dezash123/watch/README.md

Circuit board for my custom smartwatch!!!!!

[OS](https://github.com/dezash123/watch-os)

[MCAD](https://cad.onshape.com/documents/7a2f9e69e051d257ea5e1b33/)
