dezash123/watch/pcb/custom-lib/models/AFE4420YZT.step

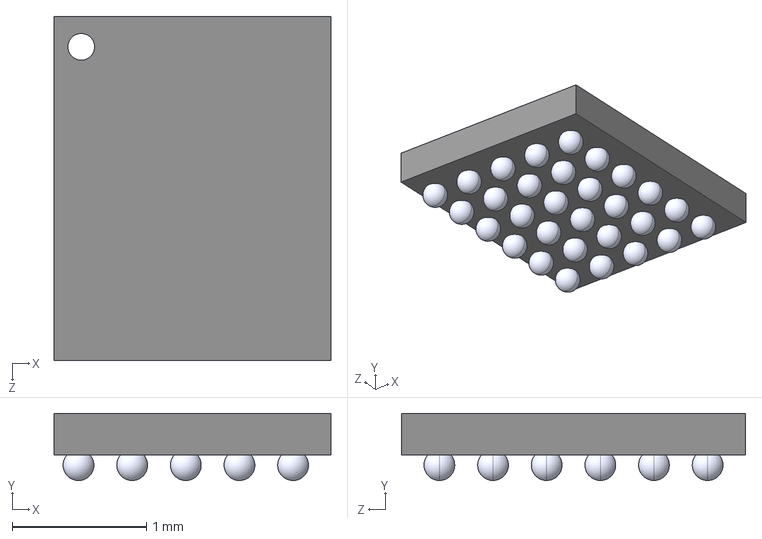
[picture p1: CAD file, 2024-07-04]
pcb/custom-lib/models/AFE4420YZT.step
2.07 x 0.5 x 2.57 mm
