dezash123/watch/pcb/custom-lib/models/MX25LM51245GXDI00.step

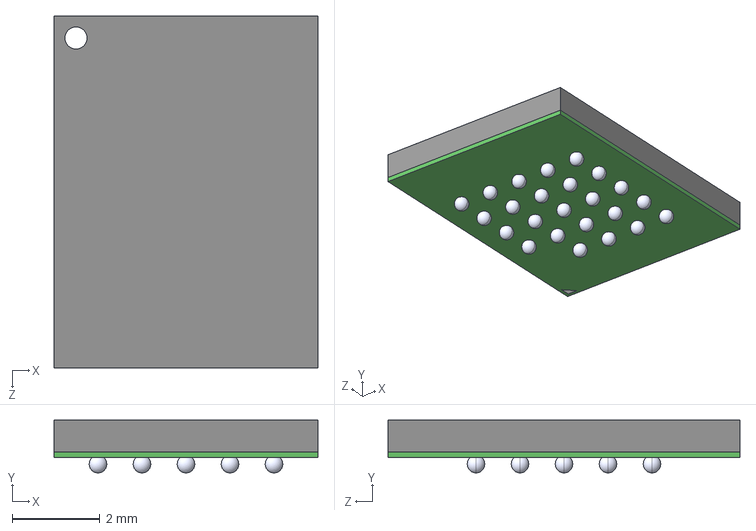
[picture p2: CAD file, 2024-07-04]
pcb/custom-lib/models/MX25LM51245GXDI00.step
6.00 x 1.20 x 8.00 mm
Body^MX25LM51245GXDI00
ball^MX25LM51245GXDI00 x 24
