dezash123/watch/pcb/custom-lib/models/MAX30102EFD_T.step

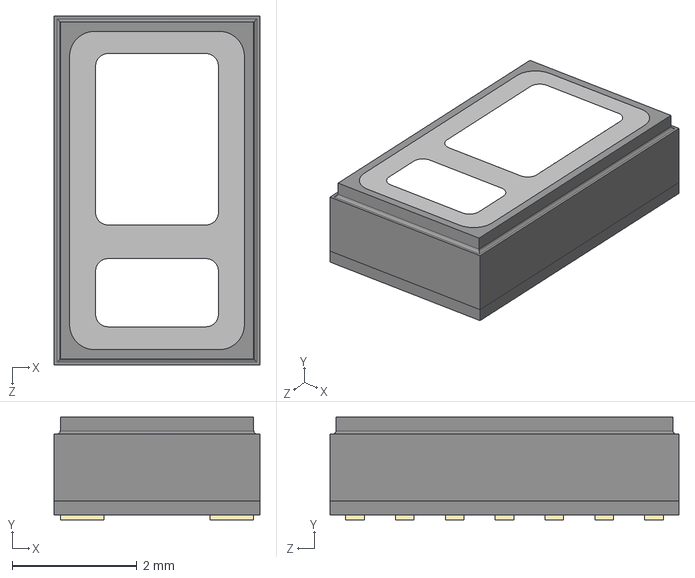
[picture p3: CAD file, 2024-07-04]
pcb/custom-lib/models/MAX30102EFD_T.step
3.30 x 1.65 x 5.60 mm
