dezash123/watch/pcb/custom-lib/models/TPS63021DSJR.step

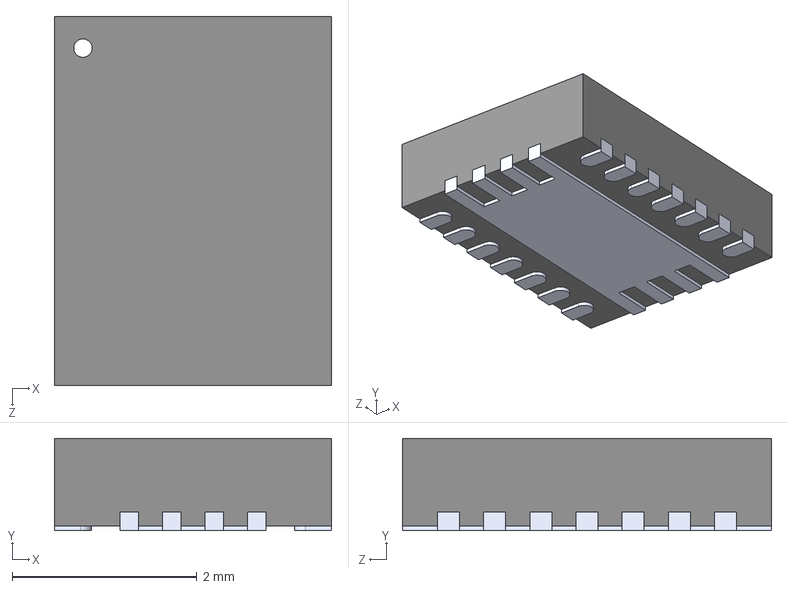
[picture p4: CAD file, 2024-07-04]
pcb/custom-lib/models/TPS63021DSJR.step
3.00 x 1.00 x 4.00 mm
