dezash123/watch/pcb/watch-pcb.kicad_pcb

## KiCad design pcb/watch-pcb.kicad_pcb (2024-07-31)

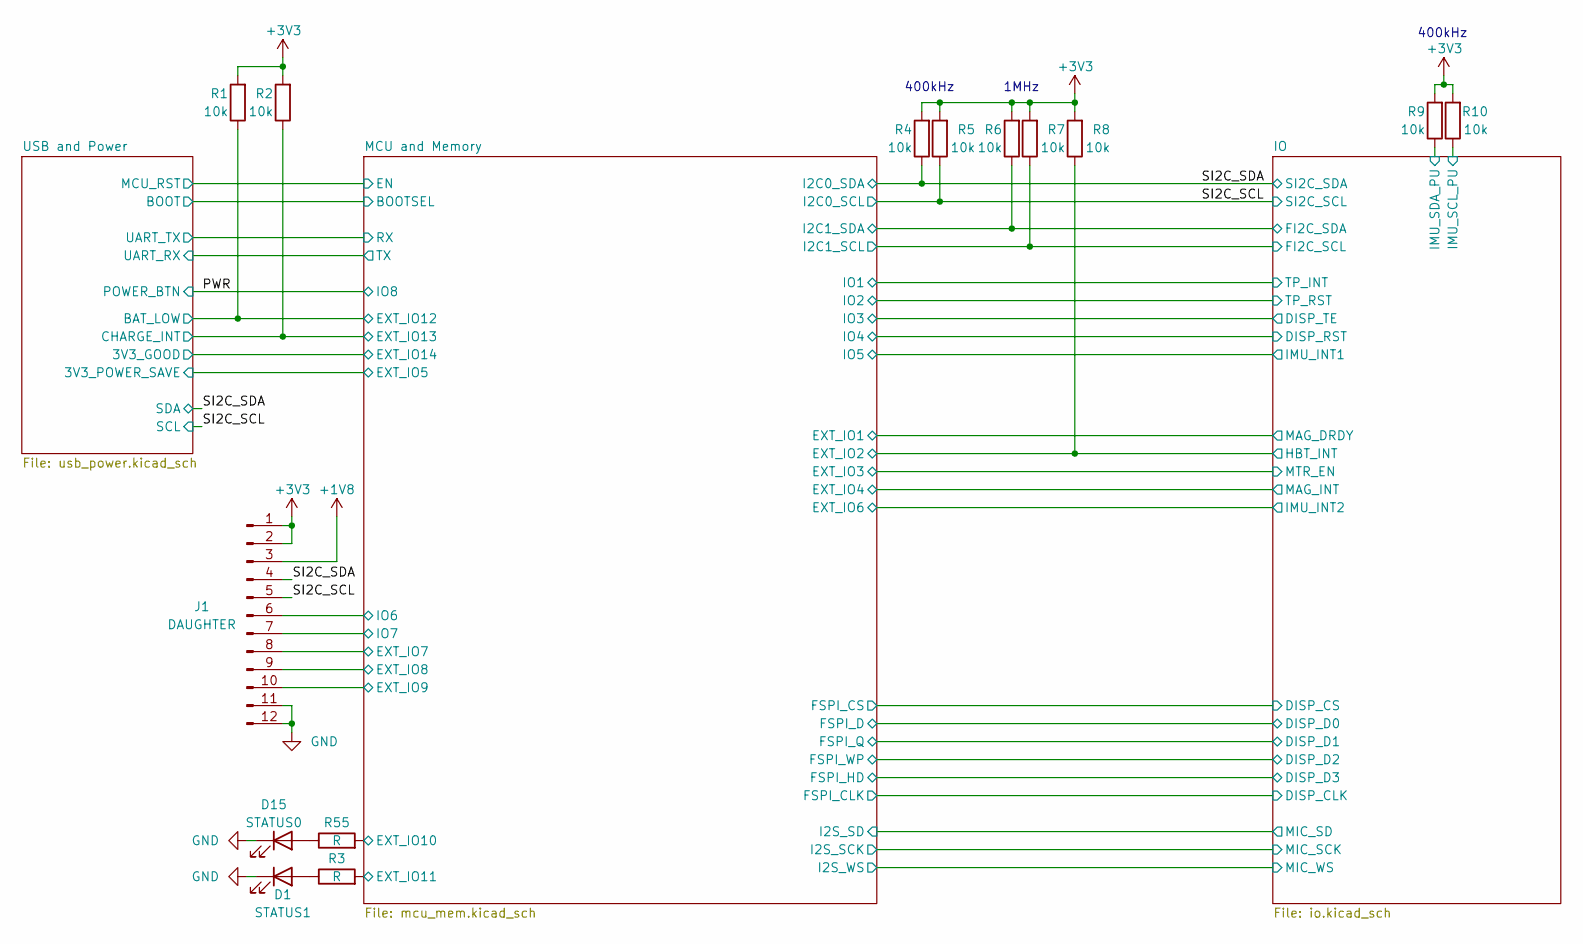
[picture p5: schematic watch-pcb.kicad_sch]

Parts:
D1: STATUS1; LED_0402_1005Metric
D15: STATUS0; LED_0402_1005Metric
J1: DAUGHTER; TE_1-1734839-2_1x12-1MP_P0.5mm_Horizontal
R1, R2, R4, R5, R6, R7, R8, R9, R10: 10k; R_0402_1005Metric
R3, R55: R; R_0402_1005Metric

Connections:
+1V8: J1.3; also elsewhere on the board
+3V3: J1.1, J1.2, R1.2, R2.2, R4.2, R5.2, R6.2, R7.2, R8.2, R9.2, R10.2; also elsewhere on the board
/IO/FI2C_SCL: R7.1; also elsewhere on the board
/IO/FI2C_SDA: R6.1; also elsewhere on the board
/IO/HBT_INT: R8.1; also elsewhere on the board
/IO/IMU_SCL: R10.1; also elsewhere on the board
/IO/IMU_SDA: R9.1; also elsewhere on the board
/MCU and Memory/EXT_IO7: J1.8; also elsewhere on the board
/MCU and Memory/EXT_IO8: J1.9; also elsewhere on the board
/MCU and Memory/EXT_IO9: J1.10; also elsewhere on the board
/MCU and Memory/EXT_IO10: R55.2; also elsewhere on the board
/MCU and Memory/EXT_IO11: R3.2; also elsewhere on the board
/MCU and Memory/EXT_IO12: R1.1; also elsewhere on the board
/MCU and Memory/EXT_IO13: R2.1; also elsewhere on the board
/MCU and Memory/IO6: J1.6; also elsewhere on the board
/MCU and Memory/IO7: J1.7; also elsewhere on the board
/SI2C_SCL: J1.5, R5.1; also elsewhere on the board
/SI2C_SDA: J1.4, R4.1; also elsewhere on the board
GND: D1.1 (K), D15.1 (K), J1.11, J1.12; also elsewhere on the board
unnamed: D1.2 (A), R3.1
unnamed: D15.2 (A), R55.1

Notes on the sheet:
400kHz
1MHz

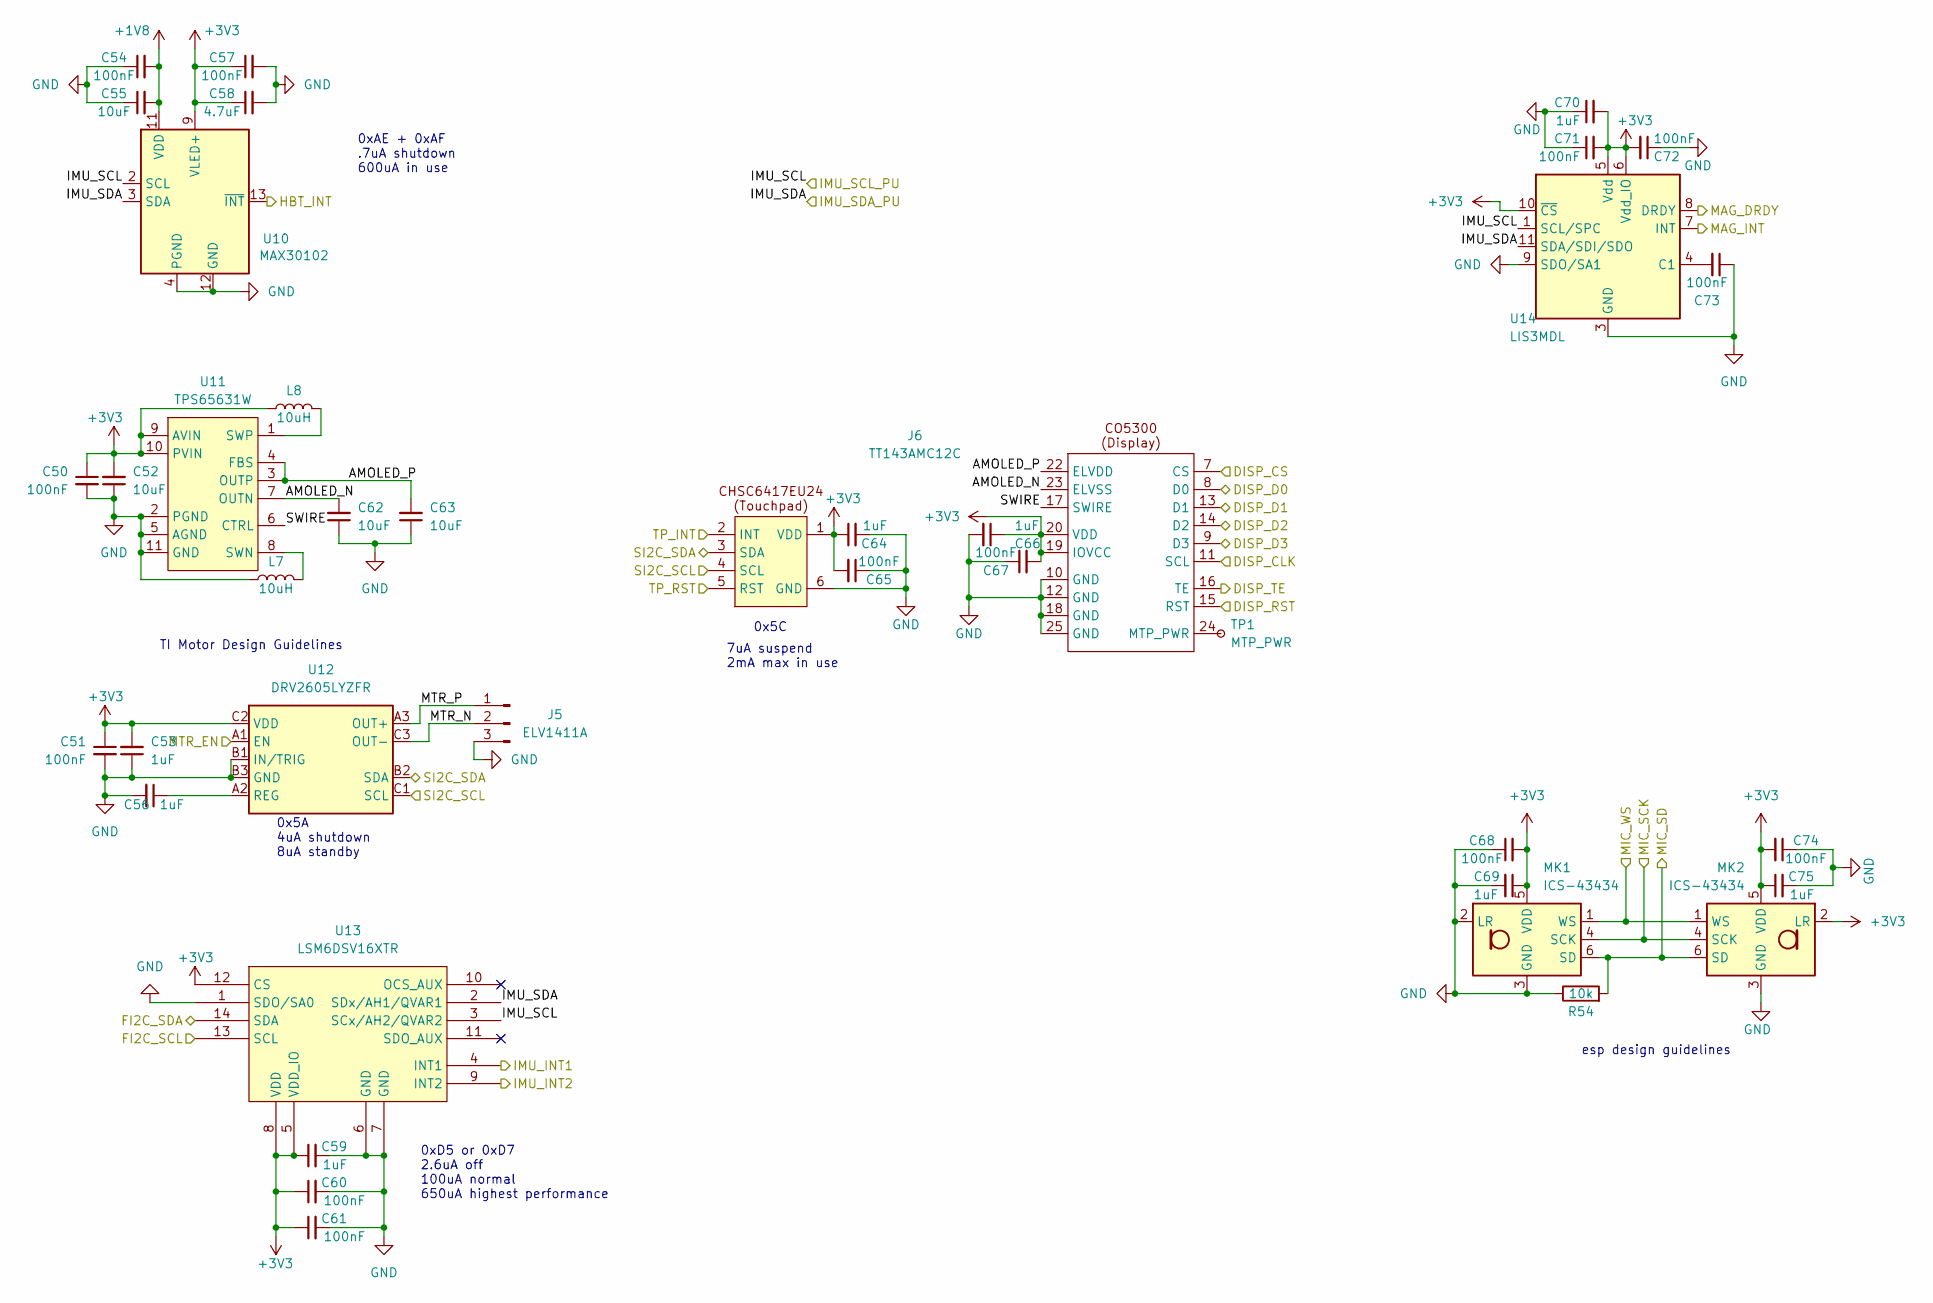
[picture p6: schematic io.kicad_sch]

Parts:
C50, C51, C54, C57, C60, C61, C65, C67, C68, C71, C72, C73, C74: 100nF; C_0402_1005Metric
C52, C55, C62, C63: 10uF; C_0402_1005Metric
C53, C56, C59, C64, C66, C69, C70, C75: 1uF; C_0402_1005Metric
C58: 4.7uF; C_0402_1005Metric
J5: ELV1411A
J6: TT143AMC12C; OK-14GF024-04
L7, L8: 10uH; L_1008_2520Metric
MK1, MK2: ICS-43434; InvenSense_ICS-43434-6_3.5x2.65mm
R54: 10k; R_0402_1005Metric
TP1: MTP_PWR; TestPoint_Pad_D1.0mm
U10: MAX30102; Maxim_OLGA-14_3.3x5.6mm_P0.8mm
U11: TPS65631W; WSON-10-1EP_2.5x2.5mm_P0.5mm_EP1.2x2mm_ThermalVias
U12: DRV2605LYZFR; Texas_DSBGA-9_1.4715x1.4715mm_Layout3x3_P0.5mm
U13: LSM6DSV16XTR; LGA-14_3x2.5mm_P0.5mm_LayoutBorder3x4y
U14: LIS3MDL; LGA-12_2x2mm_P0.5mm

Connections:
+1V8: C54.2, C55.2, U10.11 (VDD); also elsewhere on the board
+3V3: C50.1, C51.1, C52.2, C53.2, C57.1, C58.1, C59.1, C60.1, C61.1, C64.1, C65.2, C66.1, C67.2, C68.2, C69.1, C70.2, C71.2, C72.2, C74.2, C75.1, J6.1 (VDD), J6.19 (IOVCC), J6.20 (VDD), L8.1, MK1.5 (VDD), MK2.2 (LR), MK2.5 (VDD), U10.9 (VLED+), U10.10 (VLED+), U11.9 (AVIN), U11.10 (PVIN), U12.C2 (VDD), U13.5 (VDD_IO), U13.8 (VDD), U13.12 (CS), U14.5 (Vdd), U14.6 (Vdd_IO), U14.10 (~CS); also elsewhere on the board
/IO/AMOLED_N: C62.2, J6.23 (ELVSS), U11.7 (OUTN)
/IO/AMOLED_P: C63.2, J6.22 (ELVDD), U11.3 (OUTP), U11.4 (FBS)
/IO/DISP_CLK: J6.11 (SCL); also elsewhere on the board
/IO/DISP_CS: J6.7 (CS); also elsewhere on the board
/IO/DISP_D0: J6.8 (D0); also elsewhere on the board
/IO/DISP_D1: J6.13 (D1); also elsewhere on the board
/IO/DISP_D2: J6.14 (D2); also elsewhere on the board
/IO/DISP_D3: J6.9 (D3); also elsewhere on the board
/IO/DISP_RST: J6.15 (RST); also elsewhere on the board
/IO/DISP_TE: J6.16 (TE); also elsewhere on the board
/IO/FI2C_SCL: U13.13 (SCL); also elsewhere on the board
/IO/FI2C_SDA: U13.14 (SDA); also elsewhere on the board
/IO/HBT_INT: U10.13 (~INT); also elsewhere on the board
/IO/IMU_INT1: U13.4 (INT1); also elsewhere on the board
/IO/IMU_INT2: U13.9 (INT2); also elsewhere on the board
/IO/IMU_SCL: U10.2 (SCL), U13.3 (SCx/AH2/QVAR2), U14.1 (SCL/SPC); also elsewhere on the board
/IO/IMU_SDA: U10.3 (SDA), U13.2 (SDx/AH1/QVAR1), U14.11 (SDA/SDI/SDO); also elsewhere on the board
/IO/MAG_DRDY: U14.8 (DRDY); also elsewhere on the board
/IO/MAG_INT: U14.7 (INT); also elsewhere on the board
/IO/MIC_SCK: MK1.4 (SCK), MK2.4 (SCK); also elsewhere on the board
/IO/MIC_SD: MK1.6 (SD), MK2.6 (SD), R54.2; also elsewhere on the board
/IO/MIC_WS: MK1.1 (WS), MK2.1 (WS); also elsewhere on the board
/IO/MTR_EN: U12.A1 (EN); also elsewhere on the board
/IO/MTR_N: J5.2, U12.C3 (OUT-)
/IO/MTR_P: J5.1, U12.A3 (OUT+)
/IO/SWIRE: J6.17 (SWIRE), U11.6 (CTRL)
/IO/TP_INT: J6.2 (INT); also elsewhere on the board
/IO/TP_RST: J6.5 (RST); also elsewhere on the board
/SI2C_SCL: J6.4 (SCL), U12.C1 (SCL); also elsewhere on the board
/SI2C_SDA: J6.3 (SDA), U12.B2 (SDA); also elsewhere on the board
GND: C50.2, C51.2, C52.1, C53.1, C54.1, C55.1, C56.2, C57.2, C58.2, C59.2, C60.2, C61.2, C62.1, C63.1, C64.2, C65.1, C66.2, C67.1, C68.1, C69.2, C70.1, C71.1, C72.1, C73.1, C74.1, C75.2, J5.3, J6.6 (GND), J6.10 (GND), J6.12 (GND), J6.18 (GND), J6.25 (GND), L7.1, MK1.2 (LR), MK1.3 (GND), MK2.3 (GND), R54.1, U10.4 (PGND), U10.12 (GND), U11.2 (PGND), U11.5 (AGND), U11.11 (GND), U12.B1 (IN/TRIG), U12.B3 (GND), U13.1 (SDO/SA0), U13.6 (GND), U13.7 (GND), U14.2 (GND), U14.3 (GND), U14.9 (SDO/SA1), U14.12 (GND); also elsewhere on the board
unnamed: J6.24 (MTP_PWR), TP1.1
unnamed: L7.2, U11.8 (SWN)
unnamed: L8.2, U11.1 (SWP)
unnamed: C56.1, U12.A2 (REG)
unnamed: C73.2, U14.4 (C1)

Notes on the sheet:
0xAE + 0xAF .7uA shutdown 600uA in use
0xD5 or 0xD7 2.6uA off 100uA normal 650uA highest performance
esp design guidelines
TI Motor Design Guidelines
0x5C
7uA suspend 2mA max in use
0x5A 4uA shutdown 8uA standby

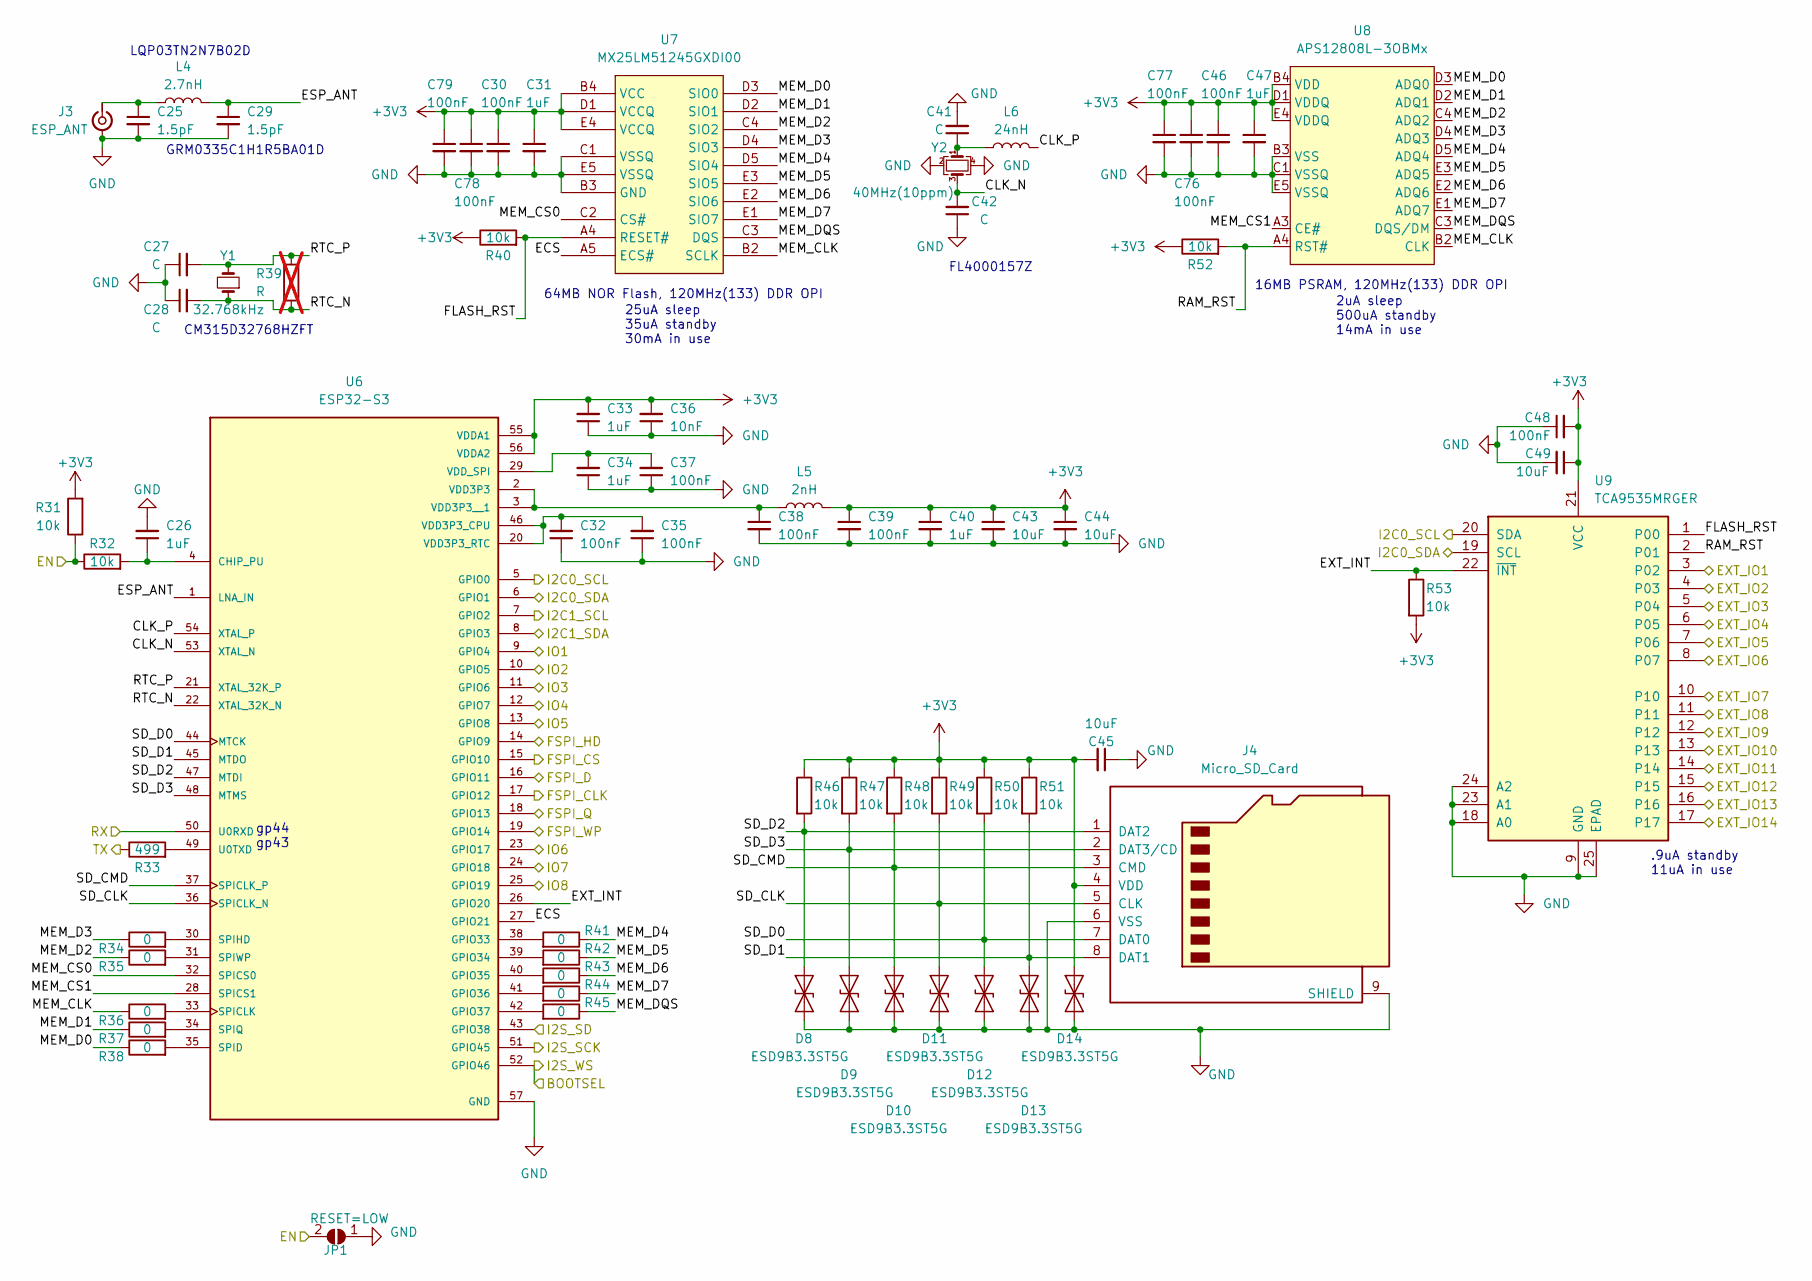
[picture p7: schematic mcu_mem.kicad_sch]

Parts:
C25, C29: 1.5pF; C_0201_0603Metric
C26, C31, C33, C34, C40, C47: 1uF; C_0402_1005Metric
C27, C28, C41, C42: C; C_0402_1005Metric
C30, C32, C35, C37, C38, C39, C46, C48, C76, C77, C78, C79: 100nF; C_0402_1005Metric
C36: 10nF; C_0402_1005Metric
C43, C44, C45, C49: 10uF; C_0402_1005Metric
D8, D9, D10, D11, D12, D13, D14: ESD9B3.3ST5G; D_SOD-923
J3: ESP_ANT; U.FL_Molex_MCRF_73412-0110_Vertical
J4: Micro_SD_Card; microSD_HC_Hirose_DM3D-SF
JP1: RESET=LOW; SolderJumper-2_P1.3mm_Open_RoundedPad1.0x1.5mm
L4: 2.7nH; L_0201_0603Metric
L5: 2nH; L_0805_2012Metric
L6: 24nH; L_Coilcraft_XFL2010
R31, R32, R40, R46, R47, R48, R49, R50, R51, R52, R53: 10k; R_0402_1005Metric
R33: 499; R_0402_1005Metric
R34, R35, R36, R37, R38, R41, R42, R43, R44, R45: 0; R_0402_1005Metric
R39: R; R_0402_1005Metric; not fitted
U6: ESP32-S3; QFN-56-1EP_7x7mm_P0.4mm_EP4x4mm_ThermalVias; PARTREV v1.2
U7: MX25LM51245GXDI00; BGA-24_6.0x8.0mm_Layout5x5_P1.0mm
U8: APS12808L-3OBMx; BGA-24_6.0x8.0mm_Layout5x5_P1.0mm
U9: TCA9535MRGER; VQFN-24-1EP_4x4mm_P0.5mm_EP2.45x2.45mm
Y1: 32.768kHz; Crystal_SMD_3215-2Pin_3.2x1.5mm
Y2: 40MHz(10ppm); Crystal_SMD_3225-4Pin_3.2x2.5mm

Connections:
+3V3: C30.1, C31.1, C33.2, C36.2, C39.1, C40.1, C43.1, C44.1, C45.2, C46.1, C47.1, C48.2, C49.1, C76.1, C77.1, C78.1, C79.1, D14.2 (A2), J4.4 (VDD), L5.2, R31.2, R40.1, R46.1, R47.1, R48.1, R49.1, R50.1, R51.1, R52.1, R53.2, U6.55 (VDDA1), U6.56 (VDDA2), U7.B4 (VCC), U7.D1 (VCCQ), U7.E4 (VCCQ), U8.B4 (VDD), U8.D1 (VDDQ), U8.E4 (VDDQ), U9.21 (VCC); also elsewhere on the board
/IO/DISP_CLK: U6.17 (GPIO12); also elsewhere on the board
/IO/DISP_CS: U6.15 (GPIO10); also elsewhere on the board
/IO/DISP_D0: U6.16 (GPIO11); also elsewhere on the board
/IO/DISP_D1: U6.18 (GPIO13); also elsewhere on the board
/IO/DISP_D2: U6.19 (GPIO14); also elsewhere on the board
/IO/DISP_D3: U6.14 (GPIO9); also elsewhere on the board
/IO/DISP_RST: U6.12 (GPIO7); also elsewhere on the board
/IO/DISP_TE: U6.11 (GPIO6); also elsewhere on the board
/IO/FI2C_SCL: U6.7 (GPIO2); also elsewhere on the board
/IO/FI2C_SDA: U6.8 (GPIO3); also elsewhere on the board
/IO/HBT_INT: U9.4 (P03); also elsewhere on the board
/IO/IMU_INT1: U6.13 (GPIO8); also elsewhere on the board
/IO/IMU_INT2: U9.8 (P07); also elsewhere on the board
/IO/MAG_DRDY: U9.3 (P02); also elsewhere on the board
/IO/MAG_INT: U9.6 (P05); also elsewhere on the board
/IO/MIC_SCK: U6.51 (GPIO45); also elsewhere on the board
/IO/MIC_SD: U6.43 (GPIO38); also elsewhere on the board
/IO/MIC_WS: U6.52 (GPIO46); also elsewhere on the board
/IO/MTR_EN: U9.5 (P04); also elsewhere on the board
/IO/TP_INT: U6.9 (GPIO4); also elsewhere on the board
/IO/TP_RST: U6.10 (GPIO5); also elsewhere on the board
/MCU and Memory/CLK_N: C42.2, U6.53 (XTAL_N), Y2.3
/MCU and Memory/CLK_P: L6.2, U6.54 (XTAL_P)
/MCU and Memory/ECS: U6.27 (GPIO21), U7.A5 (ECS#)
/MCU and Memory/EN: JP1.2 (B), R31.1, R32.1; also elsewhere on the board
/MCU and Memory/ESP_ANT: C29.1, L4.2, U6.1 (LNA_IN)
/MCU and Memory/EXT_INT: R53.1, U6.26 (GPIO20), U9.22 (~INT)
/MCU and Memory/EXT_IO5: U9.7 (P06); also elsewhere on the board
/MCU and Memory/EXT_IO7: U9.10; also elsewhere on the board
/MCU and Memory/EXT_IO8: U9.11; also elsewhere on the board
/MCU and Memory/EXT_IO9: U9.12; also elsewhere on the board
/MCU and Memory/EXT_IO10: U9.13; also elsewhere on the board
/MCU and Memory/EXT_IO11: U9.14; also elsewhere on the board
/MCU and Memory/EXT_IO12: U9.15; also elsewhere on the board
/MCU and Memory/EXT_IO13: U9.16; also elsewhere on the board
/MCU and Memory/EXT_IO14: U9.17; also elsewhere on the board
/MCU and Memory/FLASH_RST: R40.2, U7.A4 (RESET#), U9.1 (P00)
/MCU and Memory/IO6: U6.23 (GPIO17); also elsewhere on the board
/MCU and Memory/IO7: U6.24 (GPIO18); also elsewhere on the board
/MCU and Memory/MEM_CLK: R36.1, U7.B2 (SCLK), U8.B2 (CLK)
/MCU and Memory/MEM_CS0: U6.32 (SPICS0), U7.C2 (CS#)
/MCU and Memory/MEM_CS1: U6.28 (SPICS1), U8.A3 (CE#)
/MCU and Memory/MEM_D0: R38.1, U7.D3 (SIO0), U8.D3 (ADQ0)
/MCU and Memory/MEM_D1: R37.1, U7.D2 (SIO1), U8.D2 (ADQ1)
/MCU and Memory/MEM_D2: R35.1, U7.C4 (SIO2), U8.C4 (ADQ2)
/MCU and Memory/MEM_D3: R34.1, U7.D4 (SIO3), U8.D4 (ADQ3)
/MCU and Memory/MEM_D4: R41.1, U7.D5 (SIO4), U8.D5 (ADQ4)
/MCU and Memory/MEM_D5: R42.1, U7.E3 (SIO5), U8.E3 (ADQ5)
/MCU and Memory/MEM_D6: R43.1, U7.E2 (SIO6), U8.E2 (ADQ6)
/MCU and Memory/MEM_D7: R44.1, U7.E1 (SIO7), U8.E1 (ADQ7)
/MCU and Memory/MEM_DQS: R45.1, U7.C3 (DQS), U8.C3 (DQS/DM)
/MCU and Memory/RAM_RST: R52.2, U8.A4 (RST#), U9.2 (P01)
/MCU and Memory/RTC_N: C28.2, R39.2, U6.22 (XTAL_32K_N), Y1.1
/MCU and Memory/RTC_P: C27.2, R39.1, U6.21 (XTAL_32K_P), Y1.2
/MCU and Memory/RX: U6.50 (U0RXD); also elsewhere on the board
/MCU and Memory/SD_CLK: D11.2 (A2), J4.5 (CLK), R49.2, U6.36 (SPICLK_N)
/MCU and Memory/SD_CMD: D10.2 (A2), J4.3 (CMD), R48.2, U6.37 (SPICLK_P)
/MCU and Memory/SD_D0: D12.2 (A2), J4.7 (DAT0), R50.2, U6.44 (MTCK)
/MCU and Memory/SD_D1: D13.2 (A2), J4.8 (DAT1), R51.2, U6.45 (MTDO)
/MCU and Memory/SD_D2: D8.2 (A2), J4.1 (DAT2), R46.2, U6.47 (MTDI)
/MCU and Memory/SD_D3: D9.2 (A2), J4.2 (DAT3/CD), R47.2, U6.48 (MTMS)
/MCU and Memory/TX: R33.1; also elsewhere on the board
/PWR: U6.25 (GPIO19); also elsewhere on the board
/SI2C_SCL: U6.5 (GPIO0), U9.20 (SDA); also elsewhere on the board
/SI2C_SDA: U6.6 (GPIO1), U9.19 (SCL); also elsewhere on the board
GND: C25.2, C26.2, C27.1, C28.1, C29.2, C30.2, C31.2, C32.1, C33.1, C34.1, C35.1, C36.1, C37.1, C38.2, C39.2, C40.2, C41.2, C42.1, C43.2, C44.2, C45.1, C46.2, C47.2, C48.1, C49.2, C76.2, C77.2, C78.2, C79.2, D8.1 (A1), D9.1 (A1), D10.1 (A1), D11.1 (A1), D12.1 (A1), D13.1 (A1), D14.1 (A1), J3.2 (Ext), J4.6 (VSS), J4.9 (SHIELD), JP1.1 (A), U6.57 (GND), U7.B3 (GND), U7.C1 (VSSQ), U7.E5 (VSSQ), U8.B3 (VSS), U8.C1 (VSSQ), U8.E5 (VSSQ), U9.9 (GND), U9.18 (A0), U9.23 (A1), U9.24 (A2), U9.25 (EPAD), Y2.2, Y2.4; also elsewhere on the board
unnamed: C41.1, L6.1, Y2.1
unnamed: C25.1, J3.1 (In), L4.1
unnamed: C26.1, R32.2, U6.4 (CHIP_PU)
unnamed: R41.2, U6.38 (GPIO33)
unnamed: R42.2, U6.39 (GPIO34)
unnamed: R43.2, U6.40 (GPIO35)
unnamed: R44.2, U6.41 (GPIO36)
unnamed: R45.2, U6.42 (GPIO37)
unnamed: R36.2, U6.33 (SPICLK)
unnamed: R38.2, U6.35 (SPID)
unnamed: R34.2, U6.30 (SPIHD)
unnamed: R37.2, U6.34 (SPIQ)
unnamed: R35.2, U6.31 (SPIWP)
unnamed: R33.2, U6.49 (U0TXD)
unnamed: C38.1, L5.1, U6.2 (VDD3P3), U6.3 (VDD3P3__1)
unnamed: C32.2, C35.2, U6.20 (VDD3P3_RTC), U6.46 (VDD3P3_CPU)
unnamed: C34.2, C37.2, U6.29 (VDD_SPI)

Notes on the sheet:
25uA sleep 35uA standby 30mA in use
FL4000157Z
2uA sleep 500uA standby 14mA in use
GRM0335C1H1R5BA01D
CM315D32768HZFT
gp44 gp43
.9uA standby 11uA in use
16MB PSRAM, 120MHz(133) DDR OPI
LQP03TN2N7B02D
64MB NOR Flash, 120MHz(133) DDR OPI

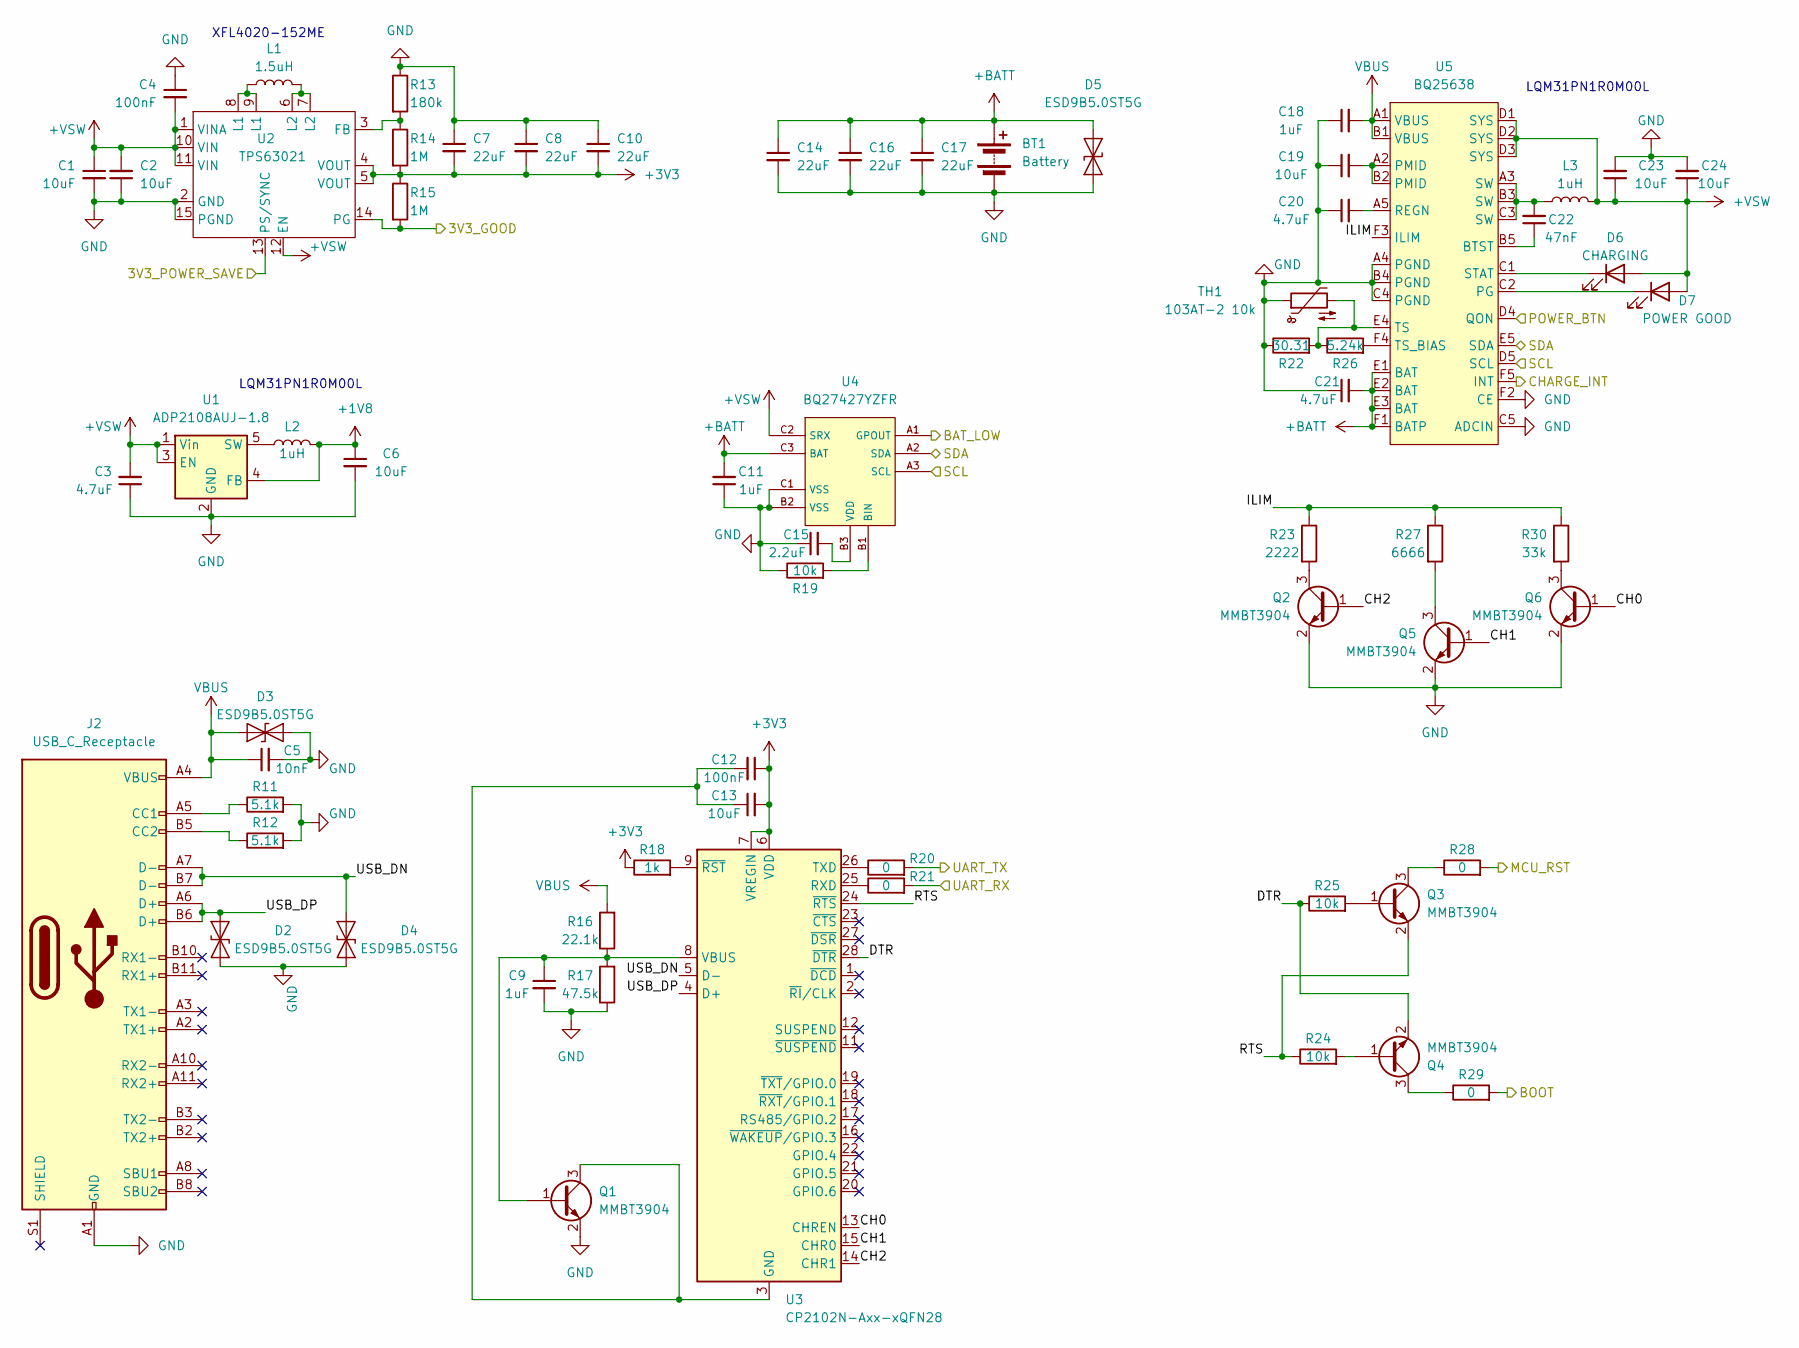
[picture p8: schematic usb_power.kicad_sch]

Parts:
BT1: Battery; Battery_Connector
C1, C2, C23, C24: 10uF; C_0603_1608Metric
C3, C20, C21: 4.7uF; C_0402_1005Metric
C4: 100nF; C_0603_1608Metric
C5: 10nF; C_0402_1005Metric
C6, C13, C19: 10uF; C_0402_1005Metric
C7, C8, C10, C14, C16, C17: 22uF; C_0603_1608Metric
C9, C11, C18: 1uF; C_0402_1005Metric
C12: 100nF; C_0402_1005Metric
C15: 2.2uF; C_0402_1005Metric
C22: 47nF; C_0402_1005Metric
D2, D3, D4, D5: ESD9B5.0ST5G; D_SOD-923
D6: CHARGING; LED_0402_1005Metric
D7: POWER GOOD; LED_0402_1005Metric
J2: USB_C_Receptacle; USB_C_Receptacle_GCT_USB4105-xx-A_16P_TopMnt_Horizontal
L1: 1.5uH; XFL4020-152ME
L2, L3: 1uH; L_1206_3216Metric
Q1, Q2, Q3, Q4, Q5, Q6: MMBT3904; SOT-23
R11, R12: 5.1k; R_0402_1005Metric
R13: 180k; R_0402_1005Metric
R14, R15: 1M; R_0402_1005Metric
R16: 22.1k; R_0402_1005Metric
R17: 47.5k; R_0402_1005Metric
R18: 1k; R_0402_1005Metric
R19, R24, R25: 10k; R_0402_1005Metric
R20, R21, R28, R29: 0; R_0402_1005Metric
R22: 30.31; R_0402_1005Metric
R23: 2222; R_0402_1005Metric
R26: 5.24k; R_0402_1005Metric
R27: 6666; R_0402_1005Metric
R30: 33k; R_0402_1005Metric
TH1: 103AT-2 10k; R_Axial_DIN0204_L3.6mm_D1.6mm_P2.54mm_Vertical
U1: ADP2108AUJ-1.8; TSOT-23-5
U2: TPS63021; Texas_VSON-14_3x4mm_ThermalPad
U3: CP2102N-Axx-xQFN28; QFN-28-1EP_5x5mm_P0.5mm_EP3.35x3.35mm
U4: BQ27427YZFR; Texas_DSBGA-9_1.4715x1.4715mm_Layout3x3_P0.5mm
U5: BQ25638; Texas_DSBGA-30_2.0x2.4mm_Layout5x6_P0.4mm

Connections:
+1V8: C6.1, L2.2, U1.4 (FB); also elsewhere on the board
+3V3: C7.2, C8.2, C10.2, C12.1, C13.2, R14.2, R15.1, R18.1, U2.4 (VOUT), U2.5 (VOUT), U3.6 (VDD), U3.7 (VREGIN); also elsewhere on the board
+BATT: BT1.1 (+), C11.2, C14.1, C16.1, C17.1, C21.2, D5.2 (A2), U4.C3 (BAT), U5.E1 (BAT), U5.E2 (BAT), U5.E3 (BAT), U5.F1 (BATP)
+VSW: C1.1, C2.2, C3.2, C4.2, C23.1, C24.1, D6.2 (A), D7.2 (A), L3.2, U1.1 (Vin), U1.3 (EN), U2.1 (VINA), U2.10 (VIN), U2.11 (VIN), U2.12 (EN), U4.C2 (SRX), U5.D1 (SYS), U5.D2 (SYS), U5.D3 (SYS)
/IO/MIC_WS: R29.2; also elsewhere on the board
/MCU and Memory/EN: R28.2; also elsewhere on the board
/MCU and Memory/EXT_IO5: U2.13 (PS/SYNC); also elsewhere on the board
/MCU and Memory/EXT_IO12: U4.A1 (GPOUT); also elsewhere on the board
/MCU and Memory/EXT_IO13: U5.F5 (INT); also elsewhere on the board
/MCU and Memory/EXT_IO14: R15.2, U2.14 (PG); also elsewhere on the board
/MCU and Memory/RX: R20.2; also elsewhere on the board
/MCU and Memory/TX: R21.2; also elsewhere on the board
/PWR: U5.D4 (QON); also elsewhere on the board
/SI2C_SCL: U4.A3 (SCL), U5.D5 (SCL); also elsewhere on the board
/SI2C_SDA: U4.A2 (SDA), U5.E5 (SDA); also elsewhere on the board
/USB and Power/CH0: Q6.1 (B), U3.13 (CHREN)
/USB and Power/CH1: Q5.1 (B), U3.15 (CHR0)
/USB and Power/CH2: Q2.1 (B), U3.14 (CHR1)
/USB and Power/DTR: Q4.2 (E), R25.1, U3.28 (~DTR)
/USB and Power/ILIM: R23.1, R27.1, R30.1, U5.F3 (ILIM)
/USB and Power/RTS: Q3.2 (E), R24.1, U3.24 (~RTS)
/USB and Power/USB_DN: D4.2 (A2), J2.A7 (D-), J2.B7 (D-), U3.5 (D-)
/USB and Power/USB_DP: D2.2 (A2), J2.A6 (D+), J2.B6 (D+), U3.4 (D+)
GND: BT1.2 (-), C1.2, C2.1, C3.1, C4.1, C5.2, C6.2, C7.1, C8.1, C9.2, C10.1, C11.1, C14.2, C15.1, C16.2, C17.2, C18.1, C19.1, C20.1, C21.1, C23.2, C24.2, D2.1 (A1), D3.2 (A2), D4.1 (A1), D5.1 (A1), J2.A1 (GND), J2.A12 (GND), J2.B1 (GND), J2.B12 (GND), Q1.2 (E), Q2.2 (E), Q5.2 (E), Q6.2 (E), R11.2, R12.2, R13.1, R17.1, R19.1, R22.1, TH1.1, U1.2 (GND), U2.2 (GND), U2.15 (PGND), U4.B2 (VSS), U4.C1 (VSS), U5.A4 (PGND), U5.B4 (PGND), U5.C4 (PGND), U5.C5 (ADCIN), U5.F2 (CE); also elsewhere on the board
unnamed: C19.2, U5.A2 (PMID), U5.B2 (PMID)
unnamed: C22.2, L3.1, U5.A3 (SW), U5.B3 (SW), U5.C3 (SW)
unnamed: D6.1 (K), U5.C1 (STAT)
unnamed: D7.1 (K), U5.C2 (PG)
unnamed: J2.A5 (CC1), R11.1
unnamed: J2.B5 (CC2), R12.1
unnamed: L1.1, U2.8 (L1), U2.9 (L1)
unnamed: L1.2, U2.6 (L2), U2.7 (L2)
unnamed: C9.1, Q1.1 (B), R16.1, R17.2, U3.8 (VBUS)
unnamed: C12.2, C13.1, Q1.3 (C), U3.3 (GND), U3.29 (GND)
unnamed: Q2.3 (C), R23.2
unnamed: Q3.1 (B), R25.2
unnamed: Q3.3 (C), R28.1
unnamed: Q4.1 (B), R24.2
unnamed: Q4.3 (C), R29.1
unnamed: Q5.3 (C), R27.2
unnamed: Q6.3 (C), R30.2
unnamed: L2.1, U1.5 (SW)
unnamed: R13.2, R14.1, U2.3 (FB)
unnamed: R21.1, U3.25 (RXD)
unnamed: R20.1, U3.26 (TXD)
unnamed: R18.2, U3.9 (~RST)
unnamed: R19.2, U4.B1 (BIN)
unnamed: C15.2, U4.B3 (VDD)
unnamed: C22.1, U5.B5 (BTST)
unnamed: C20.2, U5.A5 (REGN)
unnamed: R22.2, R26.1, TH1.2, U5.E4 (TS)
unnamed: R26.2, U5.F4 (TS_BIAS)
VBUS: C5.1, C18.2, D3.1 (A1), J2.A4 (VBUS), J2.A9 (VBUS), J2.B4 (VBUS), J2.B9 (VBUS), R16.2, U5.A1 (VBUS), U5.B1 (VBUS)

Notes on the sheet:
LQM31PN1R0M00L
XFL4020-152ME

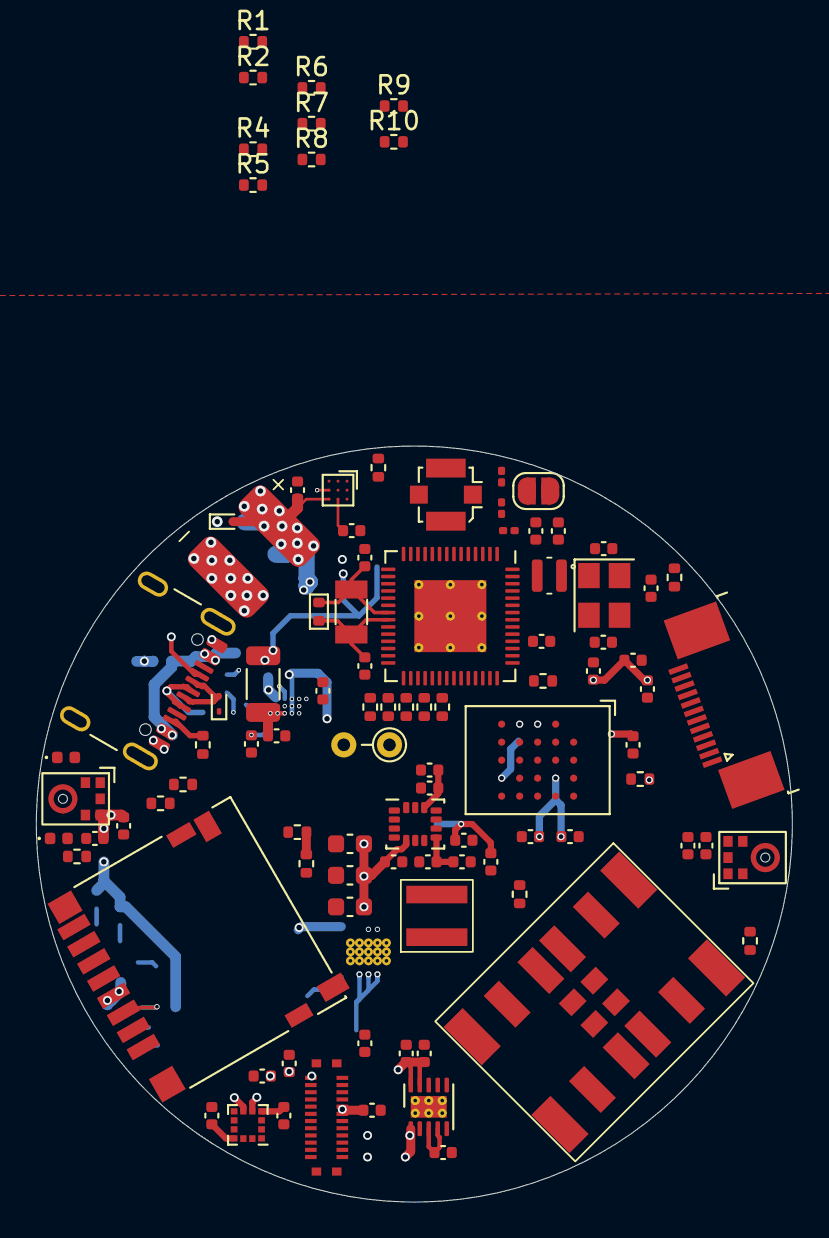
[picture p9: board watch-pcb.kicad_pcb from above]

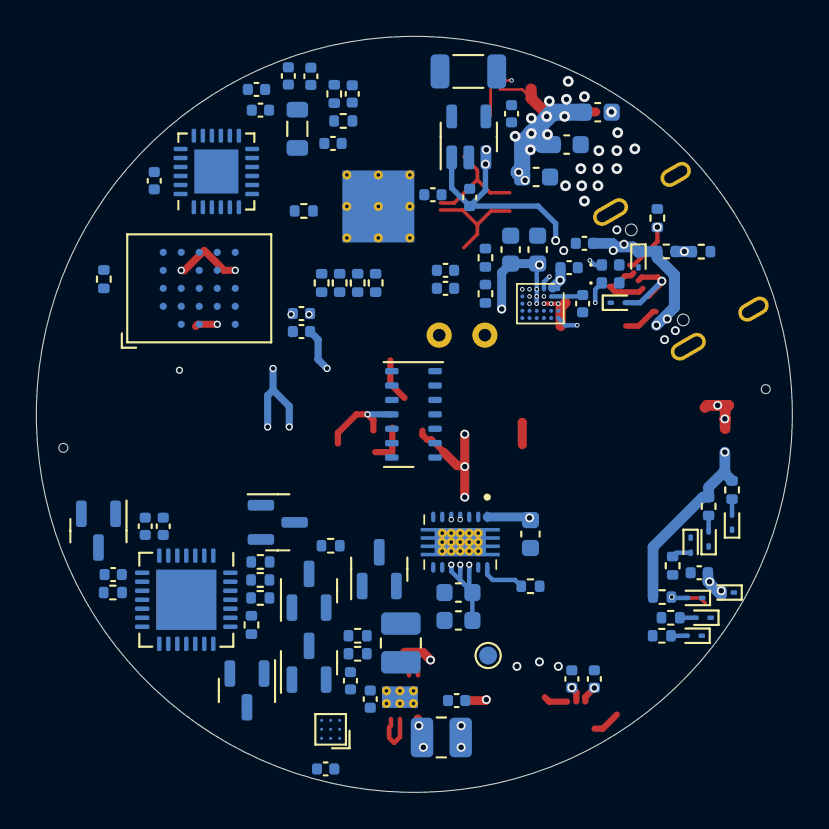
[picture p10: board watch-pcb.kicad_pcb from below]

Board: 4 copper layers, 42.0 x 42.0 mm, 191 parts (93 on the bottom side), 138 nets.
