dezash123/watch/code/src/new-os/kernel-impl/src/main.rs

#![no_std]
#![no_main]

use esp_backtrace as _;
use esp_hal::{
    clock::ClockControl, delay::Delay, peripherals::Peripherals, prelude::*, system::SystemControl,
};

#[entry]
fn main() -> ! {
    let peripherals = Peripherals::take();
    let system = SystemControl::new(peripherals.SYSTEM);

    let clocks = ClockControl::max(system.clock_control).freeze();
    let delay = Delay::new(&clocks);

    esp_println::logger::init_logger_from_env();

    let timer = esp_hal::timer::PeriodicTimer::new(
        esp_hal::timer::timg::TimerGroup::new(peripherals.TIMG1, &clocks, None)
            .timer0
            .into(),
    );

    esp_wifi::initialize(
        esp_wifi::EspWifiInitFor::Wifi,
        timer,
        esp_hal::rng::Rng::new(peripherals.RNG),
        peripherals.RADIO_CLK,
        &clocks,
    )
    .unwrap();

    loop {
        log::info!("Hello world!");
        delay.delay(500.millis());
    }
}
