dezash123/watch/code/src/drivers/src/input/touch/chsc6x/chsc6x_ramcode.h

#ifndef __CHSC6X_RAMCODE_H__
#define __CHSC6X_RAMCODE_H__

const unsigned char fw_fcode_burn[1784] = {
    0x08,0x80,0x6F,0x6D,0x00,0x00,0xF8,0x06,0x4B,0x4E,0x4C,0x54,0x80,0x01,0x88,0x00,
    0x34,0x80,0xC0,0x46,0x00,0xA0,0x17,0x09,0x17,0x0A,0x08,0x50,0x04,0xB1,0x91,0x02,
    0xFB,0xCB,0x0C,0x08,0xC0,0x6B,0x0D,0x08,0x85,0x06,0x0B,0x08,0xC0,0x6B,0x0C,0x08,
    0x85,0x06,0x0C,0x09,0x40,0xA0,0x08,0x40,0x40,0xA0,0x48,0x40,0x0A,0x09,0x0B,0x0A,
    0x0B,0x0B,0x08,0x58,0x10,0x50,0x04,0xB1,0x04,0xB2,0x9A,0x02,0xF9,0xCB,0x00,0x90,
    0xF5,0x9A,0xC0,0x46,0x12,0x00,0x00,0x00,0x13,0x00,0x00,0x00,0xF0,0x9D,0x80,0x00,
    0xF0,0x9C,0x80,0x00,0x0C,0x06,0x80,0x00,0xF8,0x06,0x00,0x00,0x04,0x8D,0x80,0x00,
    0x04,0x8D,0x80,0x00,0x04,0x8D,0x80,0x00,0x00,0xA0,0x80,0x00,0x30,0x00,0x00,0x00,
    0x4D,0x03,0x00,0x00,0x31,0x00,0x00,0x00,0x15,0x03,0x00,0x00,0x33,0x00,0x00,0x00,
    0xD9,0x04,0x00,0x00,0x32,0x00,0x00,0x00,0xD1,0x02,0x00,0x00,0x30,0x65,0x07,0x0C,
    0x01,0xA3,0x23,0x40,0x05,0xF6,0x1C,0xA0,0x00,0x90,0x9E,0x98,0x00,0xA3,0x23,0x40,
    0x03,0x0B,0x2D,0xFE,0x1D,0x40,0x00,0x90,0xC7,0x98,0x30,0x6D,0x0D,0x00,0x80,0x00,
    0x0C,0x00,0x80,0x00,0xF0,0x65,0xFA,0xA0,0xC0,0xF0,0x00,0x90,0x8D,0x98,0x05,0xA0,
    0xFF,0x97,0xE4,0x9F,0x0A,0x0C,0x0B,0x0D,0x00,0xA6,0x01,0xA7,0x05,0x80,0xC8,0xA0,
    0x01,0xBC,0x00,0x90,0x81,0x98,0x00,0xAC,0x05,0xC0,0x2E,0x40,0x00,0x90,0xAC,0x98,
    0x2B,0x48,0x1F,0x02,0xF3,0xC1,0x04,0x0B,0x01,0xA2,0x1A,0x40,0xF0,0x6D,0xC0,0x46,
    0x80,0x96,0x98,0x00,0x0C,0x00,0x80,0x00,0x0D,0x00,0x80,0x00,0x30,0x65,0x07,0x0C,
    0x03,0xFC,0x05,0xEC,0x23,0x40,0x00,0x90,0x97,0x98,0x2B,0xFA,0x23,0x40,0x00,0x90,
    0x93,0x98,0x25,0x40,0x00,0x90,0x90,0x98,0x30,0x6D,0xC0,0x46,0x0C,0x00,0x80,0x00,
    0x10,0x65,0x04,0xEC,0x06,0xA0,0xFF,0x97,0xB1,0x9F,0x20,0xA0,0xFF,0x97,0xAE,0x9F,
    0x20,0xEC,0xFF,0x97,0xE3,0x9F,0x03,0x0B,0x01,0xA2,0x1A,0x40,0xFF,0x97,0xBA,0x9F,
    0x10,0x6D,0xC0,0x46,0x0D,0x00,0x80,0x00,0xF0,0x65,0x04,0xEC,0x03,0xA0,0x0D,0xEC,
    0x16,0xEC,0x0E,0x0F,0xFF,0x97,0x9A,0x9F,0x20,0xEC,0xFF,0x97,0xCF,0x9F,0x00,0xA3,
    0x3B,0x40,0x00,0x90,0x69,0x98,0x0A,0x0B,0x0A,0xA2,0x1A,0x40,0x00,0x90,0x64,0x98,
    0x00,0xAD,0x07,0xC0,0x00,0xA4,0x3B,0x48,0x33,0x15,0x01,0xB4,0x00,0x90,0x5C,0x98,
    0xAC,0x02,0xF8,0xC1,0x02,0x0B,0x01,0xA2,0x1A,0x40,0xF0,0x6D,0x0C,0x00,0x80,0x00,
    0x0D,0x00,0x80,0x00,0xF0,0x65,0x04,0xEC,0x06,0xA0,0x0D,0xEC,0x16,0xEC,0xFF,0x97,
    0x75,0x9F,0x02,0xA0,0xFF,0x97,0x72,0x9F,0x20,0xEC,0xFF,0x97,0xA7,0x9F,0x00,0xAD,
    0x08,0xC0,0x07,0x0F,0x00,0xA4,0x33,0x1D,0x01,0xB4,0x3B,0x40,0x00,0x90,0x3C,0x98,
    0xA5,0x02,0xF8,0xC8,0x03,0x0B,0x01,0xA2,0x1A,0x40,0xFF,0x97,0x73,0x9F,0xF0,0x6D,
    0x0C,0x00,0x80,0x00,0x0D,0x00,0x80,0x00,0x06,0x09,0x0B,0x58,0x81,0x60,0x00,0x33,
    0x43,0xF0,0x18,0xE8,0xC0,0xF0,0x0A,0x58,0x00,0x3B,0xD3,0xEA,0x83,0x02,0xFA,0xC9,
    0x01,0x60,0x70,0x07,0x30,0x06,0x80,0x00,0x10,0x65,0x94,0xE0,0x00,0xAC,0x05,0xCD,
    0x00,0xA3,0x04,0xD9,0x01,0xB3,0x04,0xD0,0xA3,0x02,0xFA,0xC1,0x10,0x6D,0xC0,0x46,
    0x10,0x65,0x09,0xF4,0x49,0xFC,0x03,0xEC,0x00,0xA0,0x00,0xA9,0x0B,0xC0,0x4C,0xEE,
    0x24,0xF4,0xE4,0xFB,0x02,0xB4,0x00,0xA2,0x99,0x1A,0x40,0xE8,0x00,0xF4,0x02,0xB2,
    0x00,0xFC,0xA2,0x02,0xF8,0xC1,0x10,0x6D,0x30,0x65,0x06,0x0D,0x2B,0x48,0xDA,0xF6,
    0x06,0xC5,0x10,0xA4,0x1C,0xA0,0xFF,0x97,0xC7,0x9F,0x2B,0x48,0x1C,0x02,0xF9,0xC1,
    0x30,0x6D,0xC0,0x46,0x0D,0x00,0x80,0x00,0x01,0x0B,0x01,0xA2,0x1A,0x40,0x70,0x07,
    0x0D,0x00,0x80,0x00,0x01,0x0B,0x00,0xA2,0x1A,0x40,0x70,0x07,0x0D,0x00,0x80,0x00,
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
};

#endif
