dezash123/watch/code/src/drivers/src/input/touch/chsc6x/chsc6x_flash_boot.h

#ifndef __CHSC6X_FLASH_BOOT_H__
#define __CHSC6X_FLASH_BOOT_H__

const unsigned char chsc_boot[] = {
	0x43,0x48,0x53,0x43,0x00,0x00,0x00,0x00,0x01,0x00,0x00,0x00,0x01,0x00,0x00,0x00,
	0xCC,0x00,0x00,0x00,0x8C,0x36,0x00,0x00,0x01,0xC6,0x0E,0x00,0x01,0xC6,0x0E,0x08,
	0x01,0x3C,0x02,0x93,0x1B,0x02,0x02,0x00,0x00,0x01,0x0F,0x01,0x13,0x0F,0x43,0x0A,
	0x0A,0x16,0x00,0x00,0x00,0x00,0x00,0x00,0x00,0x00,0x0D,0x10,0x0C,0x00,0x00,0x00,
	0x00,0x0B,0x08,0x03,0x01,0x04,0x05,0x09,0x02,0x06,0x00,0x00,0x00,0x00,0x00,0x00,
	0x00,0x07,0x0A,0x0F,0x0E,0x11,0x00,0x00,0x00,0x00,0x00,0x00,0x00,0x00,0x00,0x00,
	0x00,0x00,0x18,0x45,0x91,0x02,0x38,0x00,0x72,0x01,0x72,0x01,0x50,0x00,0xF0,0x00,
	0x90,0x01,0x00,0x02,0x84,0x03,0x20,0x10,0x78,0x78,0x78,0x78,0x64,0x40,0x08,0x84,
	0x08,0x1E,0x26,0x23,0x28,0x26,0x5C,0x0B,0x90,0x08,0x46,0x46,0x23,0x23,0x65,0xBD,
	0x1B,0x06,0x11,0x20,0x03,0x19,0x84,0xAF,0x9E,0x40,0x91,0x01,0xC8,0x60,0x2C,0x2D,
	0x25,0x11,0x32,0x6A,0x80,0x32,0x21,0x46,0xC8,0x28,0xDA,0x6B,0x59,0x05,0x84,0xA2,
	0x26,0x06,0x33,0x08,0x22,0x06,0x2B,0x08,0xF7,0x05,0x07,0x08,0x3E,0x06,0x95,0x08,
	0x00,0x00,0x34,0x2D,0x34,0x2D,0x00,0x00,0x00,0x00,0xD6,0x02,0x0E,0x00,0x08,0x08,
	0x28,0x10,0x32,0x03,0x51,0x32,0x01,0x21,0x19,0x19,0x11,0x12,0x13,0x13,0x11,0x19,
	0x1A,0x1A,0x1D,0x1B,0x1A,0x19,0x19,0x82,0x08,0x80,0x36,0x35,0x2D,0x02,0x88,0x36,
	0xBD,0x4E,0x4C,0x54,0x40,0x00,0x88,0x00,0x4A,0x80,0xC0,0x46,0x00,0xA0,0x20,0x09,
	0x20,0x0A,0x08,0x50,0x04,0xB1,0x91,0x02,0xFB,0xCB,0x13,0x08,0xC0,0x6B,0x14,0x08,
	0x85,0x06,0x12,0x08,0xC0,0x6B,0x13,0x08,0x85,0x06,0x1B,0x08,0x1B,0x09,0x10,0x0A,
	0x08,0x50,0x04,0xB1,0x91,0x02,0xFB,0xCB,0x10,0x09,0x11,0x0A,0x00,0xA0,0x08,0x50,
	0x04,0xB1,0x91,0x02,0xFB,0xCD,0x0C,0x09,0x04,0xA0,0x08,0x40,0x05,0xA0,0x48,0x40,
	0x0C,0x09,0x0D,0x0A,0x0D,0x0B,0x08,0x58,0x10,0x50,0x04,0xB1,0x04,0xB2,0x9A,0x02,
	0xF9,0xCB,0x01,0x90,0x19,0x9C,0xC0,0x46,0x12,0x00,0x00,0x00,0x13,0x00,0x00,0x00,
	0xFC,0x9D,0x80,0x00,0xFC,0x9C,0x80,0x00,0x0C,0x06,0x80,0x00,0x00,0x84,0x80,0x00,
	0x00,0x85,0x80,0x00,0x10,0x36,0x00,0x00,0x04,0x8D,0x80,0x00,0x7C,0x8D,0x80,0x00,
	0x00,0x84,0x80,0x00,0x00,0xA0,0x80,0x00,0xCE,0xFA,0xAD,0xDE,0xE0,0x93,0x80,0x00,
	0x00,0x65,0x0F,0x64,0xD8,0x6B,0x01,0x64,0xF0,0x64,0x4F,0x06,0x56,0x06,0x5D,0x06,
	0x64,0x06,0xF0,0x64,0x44,0x06,0x10,0x64,0x00,0x90,0x10,0x99,0x10,0x6C,0xA0,0x06,
	0xF0,0x6C,0xB9,0x06,0xB2,0x06,0xAB,0x06,0xA4,0x06,0xF0,0x6C,0x01,0x6C,0xD0,0x6B,
	0x0F,0x6C,0x00,0x69,0x00,0x00,0x00,0x00,0x03,0xA2,0x05,0x80,0x01,0xA2,0x03,0x80,
	0x02,0xA2,0x01,0x80,0x00,0xA2,0xFF,0x87,0xCB,0x6B,0x18,0x64,0x80,0xA4,0x23,0x03,
	0xC3,0x6B,0x09,0x0B,0x18,0x50,0x04,0xB3,0x19,0x50,0x08,0xBB,0x1A,0x40,0x18,0x48,
	0x00,0xA8,0xFC,0xC1,0x01,0xAA,0x02,0xC9,0x08,0xB3,0x18,0x58,0x01,0x80,0x04,0xB3,
	0x18,0x58,0x18,0x6C,0xC3,0x6B,0x70,0x07,0x64,0x06,0x80,0x00,0x60,0x06,0x80,0x00,
	0x68,0x06,0x80,0x00,0xC0,0x46,0xC0,0x46,0x01,0x08,0x08,0x01,0x01,0x08,0x08,0x01,
	0x00,0xFA,0xAA,0x00,0x00,0xFA,0xB4,0x00,0x01,0x08,0x08,0x01,0x01,0x08,0x08,0x01,
	0x00,0xFA,0xAA,0x00,0x00,0xFA,0xB4,0x00,0x01,0x08,0x08,0x01,0x01,0x08,0x08,0x01,
	0x00,0xFA,0xAA,0x00,0x00,0xFA,0xB4,0x00,0x01,0x08,0x08,0x01,0x01,0x08,0x08,0x01,
	0x00,0xFA,0xAA,0x00,0x00,0xFA,0xB4,0x00,0x70,0x65,0x00,0x90,0x67,0x99,0x24,0x0B,
	0x00,0xA2,0x1A,0x40,0x23,0x0A,0xB9,0xA1,0x11,0x40,0x1A,0x48,0x00,0xAA,0xFC,0xC1,
	0x1F,0x0B,0x01,0xA2,0x1A,0x40,0x20,0x0C,0x20,0x0E,0x81,0xA5,0x06,0xA1,0x06,0xA0,
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
};

#endif
