dezash123/watch/(commit log)

2024-01-20 pcb stuff
    [watch_pcb.kicad_pcb, watch_pcb.kicad_sch]
2024-04-01 idk some stuff
    [watch_pcb.csv, watch_pcb.kicad_pcb, watch_pcb.kicad_sch]
2024-05-11 refactoring more
    [watch_pcb.csv, watch_pcb.kicad_pcb, watch_pcb.kicad_sch]
2024-05-19 too much to list
    [config.rs, consts.rs, display.rs, drivers.rs, i2c.rs, imu.rs]
2024-06-03 move pcb to separate repo
    [watch_pcb.csv, watch_pcb.kicad_pcb, watch_pcb.kicad_sch]
2024-06-05 custom symbols moar
    [watch-pcb.kicad_pcb]
2024-06-05 might switch to c/++ :'(
2024-06-08 display started
    [watch-pcb.kicad_sch]
2024-06-13 finished schematic, verifying design and doing daughter board
    [AFE4420YZT.step, MAX30102EFD_T.step, MX25LM51245GXDI00.step, TPS63021DSJR.step, watch-pcb.kicad_pcb, watch-pcb.kicad_sch]
2024-06-30 nearly done with schematic i thinks
    [daughter-board.kicad_pcb, daughter-board.kicad_sch, io.kicad_sch, mcu_mem.kicad_sch, usb_power.kicad_sch, watch-pcb.kicad_pcb, watch-pcb.kicad_sch]
2024-07-04 basically done probably
    [daughter-board.kicad_pcb, daughter-board.kicad_sch, watch-pcb.kicad_pcb, watch-pcb.kicad_sch]
2024-07-04 switching to one repo
2024-07-04 switching to single repo
    [io.kicad_sch]
2024-07-04 Move pcb files into subdir
    [AFE4420YZT.step, MAX30102EFD_T.step, MX25LM51245GXDI00.step, TPS63021DSJR.step, daughter-board.kicad_pcb, daughter-board.kicad_sch, io.kicad_sch, mcu_mem.kicad_sch]
2024-07-17 git is a tool for torture
    [mcu_mem.kicad_sch, usb_power.kicad_sch]
2024-07-30 finished pcb layout
    [daughter-board.kicad_sch, io.kicad_sch, mcu_mem.kicad_sch, usb_power.kicad_sch, watch-pcb.kicad_pcb, watch-pcb.kicad_sch]
2024-07-31 switching to 6 layer
    [usb_power.kicad_sch, watch-pcb.kicad_pcb]
